keith-packard/snekboard/(list of files, drawings)

Other design files:
snekboard.pcb
