keith-packard/snekboard/(commit log)

2019-06-12 Initial import
    [sneklego.pcb, sneklego.sch]
2019-06-15 First complete version
    Down to 48x48mm, 8 general I/O, 4 motor.
    [sneklego.pcb, sneklego.sch]
2019-06-15 Move ids around
    Make the PCB a bit more readable
    [sneklego.pcb]
2019-06-15 Add flash and debug
    Forgot the debug connector.
    Add flash part to allow the board to run Circuit Python if desired.
    [sneklego.pcb, sneklego.sch]
2019-06-15 Rename to snekboard
    [snekboard.pcb, snekboard.sch]
2019-06-15 Add README and board rendering
2019-06-15 Add a couple neopixels
    Stick them on either side of the GPIO connector
    [snekboard.pcb, snekboard.sch]
2019-06-16 Fix attributes so that the partslists are complete
    [snekboard.pcb, snekboard.sch]
2019-07-01 Add TPS2121 switch, change to DRV8800 motor controller
    TPS2121 switch automatically selects between battery and USB power
    with less voltage drop and (we hope) no leakage backwards.
    DRV8800 handles more current and should let the power functions medium
    motor work.
    [snekboard.pcb, snekboard.sch]
2019-07-02 forward annotate part value changes
    These were needed to generate an accurate parts list
    [snekboard.pcb]
2019-07-02 Shrink all refdes on the PCB
    Make them fit, although they probably won't be that readable.
    [snekboard.pcb]
2019-07-02 Fix clearance around SoC pads
    Make it possible to place a ground plane on the top of the board
    [snekboard.pcb]
2019-07-02 Move some component values around in the schematic
    Try to get all IC values in the middle of the part
    [snekboard.sch]
2019-07-02 Flood the top of the PCB
    And connect ground to it.
    [snekboard.pcb]
2019-07-02 Fix text on bottom of board
    [snekboard.pcb]
2019-07-02 Lost the SAMD21G18A value on the SoC
    This caused the partslist to be mis-generated.
    [snekboard.sch]
2019-07-02 Update board image file
2019-10-29 Add comparator to disable 9V when battery sags
    This uses the same plan as the Altus Metrum pyro circuits to avoid
    browning-out the SoC when current demands cause the battery voltage to sag.
    [snekboard.pcb, snekboard.sch]
2019-10-29 Adjust neopixel locations, clear space in corners
    The upper left corner required swapping package for the flash part to
    a uson-8. The neopixels now have enough space that centering them on
    the pads should provide enough clearance from the 3x8 block and the
    corners
    We should be able to have three corners covered by lego 2x2 plates to
    hold the board inside the box.
    [snekboard.pcb, snekboard.sch]
2019-11-14 Tweak power supply bits
    Place voltage limit on 9V enable comparator at 3.75V instead of 3.5V
    Increase slow start time of 9V supply from 2.7ms to 58ms.
    Fix pinouts of comparator (uses the "other" standard op-amp pinout).
    [snekboard.pcb, snekboard.sch]
2019-11-18 Cost reduce 0.1µF caps and crystal
    Switch from 25V caps to 16V (0.03 -> 0.01 q1000)
    Switch from Abracon to Epson crystal (0.45 -> 0.22 q100)
    [snekboard.pcb, snekboard.sch]
2019-11-18 Switch 10µF cap to 16V part instead of 10V
    We're using one on the high voltage side of the boost regulator, 10V
    just doesn't seem right. I think this one will be slightly cheaper, if
    anything though.
2019-11-19 Re-route inputs to power selector to avoid narrow spot
    Routing the USB power between the two switch terminals caused
    a choke-point, which could cause strange heating there. Swap the inputs
    to the power selector so that USB power can be routed cleanly.
    [snekboard.pcb, snekboard.sch]
2019-11-19 Avoid error when creating $(PROJECT).all-drill.cnc
    There may be onlye one of the two input files ( *.plated-drill.cnc
    and *.unplated-drill.cnc), so just use a glob to match them
    instead of listing names which might not exist.
2019-12-19 Add more copper around giant cap pads
    Try to keep them from getting ripped off the board.
    [snekboard.pcb]
2020-02-19 Move flash part out of the corner
    Leave the corner bare.
    [snekboard.pcb]
